marioqqq/Rack_2020-profiles/Rack.3mf

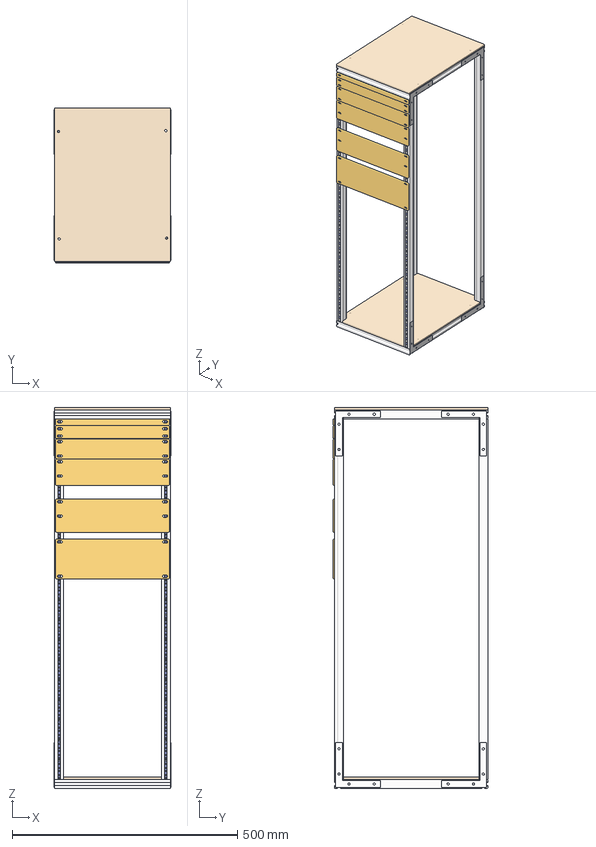
[picture p4: CAD file, 2026-11-01]
Rack.3mf
259.5 x 343.0 x 845.1 mm
Bracket_BottomBackLeft
Bracket_BottomBackRight
Bracket_BottomFrontLeft
Bracket_BottomFrontRight
Bracket_TopBackLeft
Bracket_TopBackRight
Bracket_TopFrontLeft
Bracket_TopFrontRight
Desk_Bottom
Desk_Top
Plate_1U
Plate_1n3U
Plate_2U
Plate_2n3U
Plate_4n3U
Plate_5n3U
Profile_BackLeft
Profile_BackRight
Profile_BottomBack
Profile_BottomFront
Profile_BottomLeft
Profile_BottomRight
Profile_FrontLeft
Profile_FrontRight
Profile_TopBack
Profile_TopFront
Profile_TopLeft
Profile_TopRight
Unit (1) x 36
Unit (2) x 36
Unit (3) x 36
Unit x 36
