marioqqq/Rack_2020-profiles/(list of files, cad)

Other CAD files:
Rack.f3d
